eta4ever/ay-serial/pcb/pcb.png

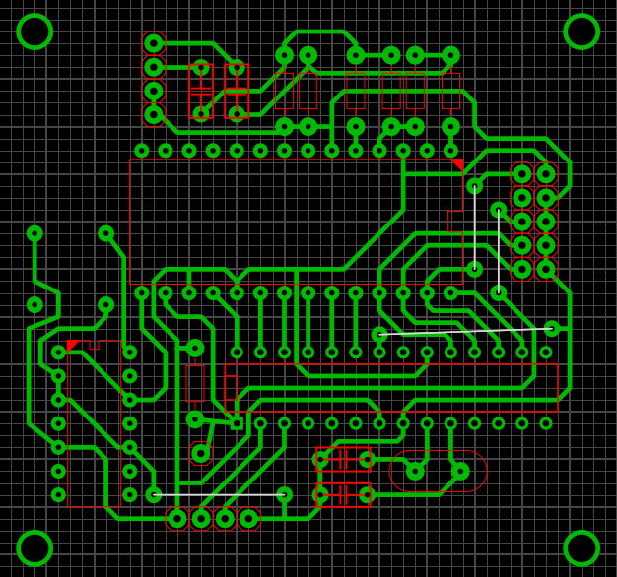
pcb/pcb.png
