eta4ever/ay-serial/sch/sch.png

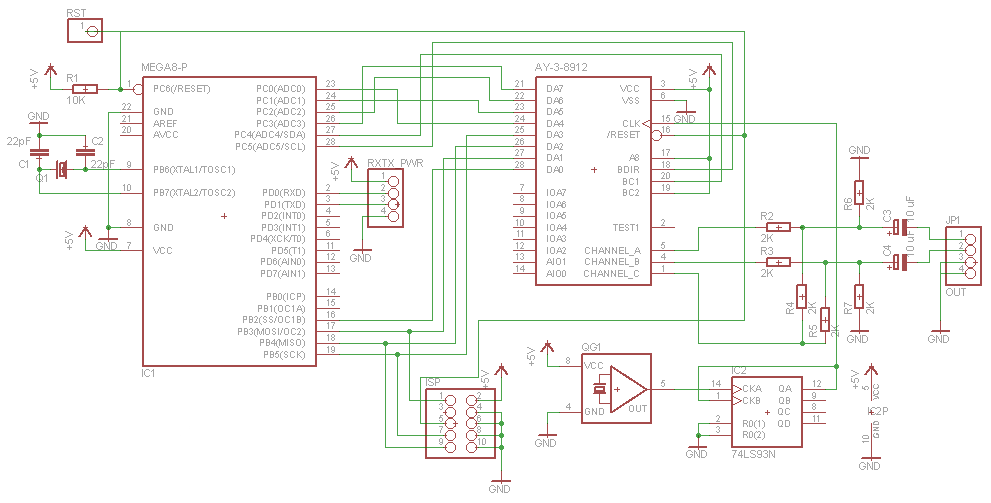
sch/sch.png
