eta4ever/ay-serial/(list of files, drawings)

Other design files:
pcb/chiptune-mega8.lay6
