eta4ever/ay-serial/sch/sch.sch

## EAGLE design sch/sch.sch (2015-03-14)

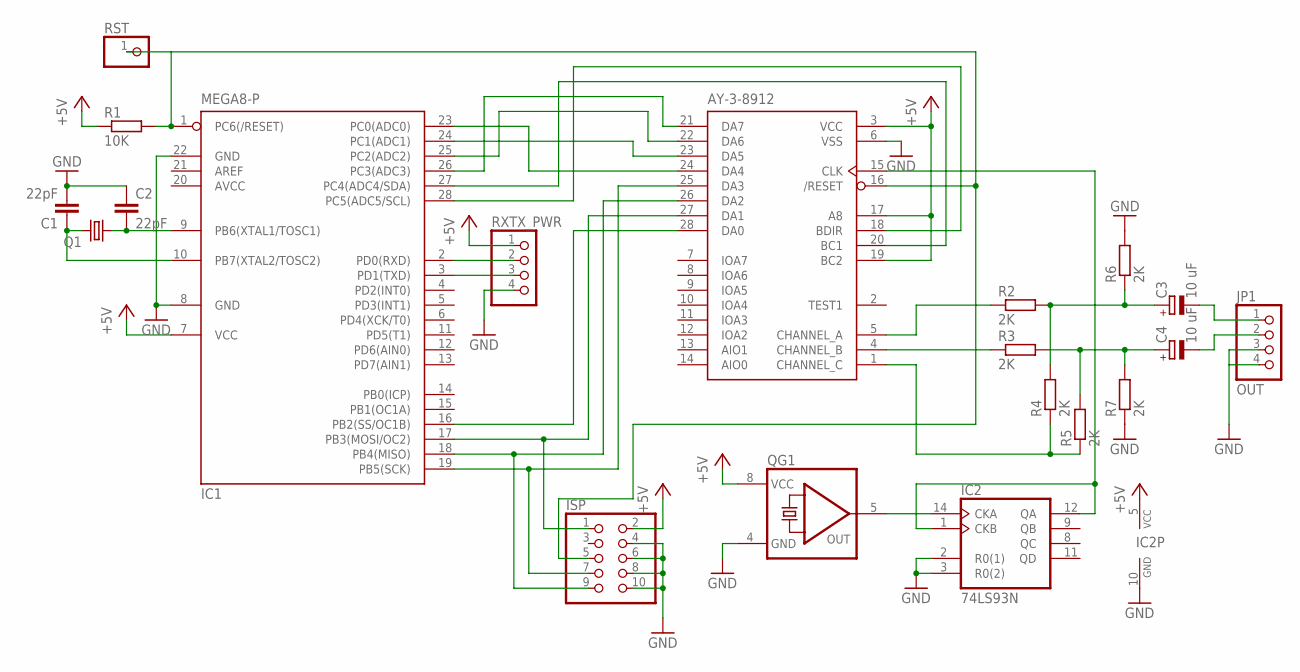
[picture p3: schematic sch.sch]

Parts:
AY-3-8912: AY-3-8912_28PIN; DIL28
C1, C2: 22pF; C2.5-3
C3, C4: 10 uF; E2,5-6E
IC1: MEGA8-P; DIL28-3
IC2: 74LS93N; DIL14
ISP: PINHD-2X5; 2X05
JP1: OUT; 1X04
Q1: CRYSTALHC49U-V; HC49U-V
QG1: QG5460; DIL08S
R1: 10K; 0204/7
R2, R3, R4, R5, R6, R7: 2K; 0204/7
RST: PINHD-1X1; 1X01
RXTX_PWR: PINHD-1X4; 1X04

Connections:
+5V: AY-3-8912.3 (VCC), AY-3-8912.17 (A8), AY-3-8912.19 (BC2), IC1.7 (VCC), IC2.5 (VCC), ISP.2, QG1.8 (VCC), R1.1, RXTX_PWR.1
GND: AY-3-8912.6 (VSS), C1.2, C2.1, IC1.8 (GND), IC1.22 (GND), IC2.2 (R0(1)), IC2.3 (R0(2)), IC2.10 (GND), ISP.4, ISP.6, ISP.8, ISP.10, JP1.3, JP1.4, QG1.4 (GND), R6.2, R7.1, RXTX_PWR.4
unnamed: AY-3-8912.24 (DA4), IC1.23 (PC0(ADC0))
unnamed: AY-3-8912.23 (DA5), IC1.24 (PC1(ADC1))
unnamed: AY-3-8912.22 (DA6), IC1.25 (PC2(ADC2))
unnamed: AY-3-8912.21 (DA7), IC1.26 (PC3(ADC3))
unnamed: AY-3-8912.28 (DA0), IC1.16 (PB2(SS/OC1B))
unnamed: AY-3-8912.27 (DA1), IC1.17 (PB3(MOSI/OC2)), ISP.1
unnamed: AY-3-8912.26 (DA2), IC1.18 (PB4(MISO)), ISP.9
unnamed: AY-3-8912.25 (DA3), IC1.19 (PB5(SCK)), ISP.7
unnamed: AY-3-8912.20 (BC1), IC1.27 (PC4(ADC4/SDA))
unnamed: AY-3-8912.18 (BDIR), IC1.28 (PC5(ADC5/SCL))
unnamed: AY-3-8912.16 (/RESET), IC1.1 (PC6(/RESET)), ISP.5, R1.2, RST.1
unnamed: C2.2, IC1.9 (PB6(XTAL1/TOSC1)), Q1.1
unnamed: C1.1, IC1.10 (PB7(XTAL2/TOSC2)), Q1.2
unnamed: IC2.14 (CKA), QG1.5 (OUT)
unnamed: AY-3-8912.5 (CHANNEL_A), R2.1
unnamed: AY-3-8912.15 (CLK), IC2.1 (CKB), IC2.12 (QA)
unnamed: IC1.2 (PD0(RXD)), RXTX_PWR.2
unnamed: IC1.3 (PD1(TXD)), RXTX_PWR.3
unnamed: AY-3-8912.4 (CHANNEL_B), R3.1
unnamed: C3.+, R2.2, R4.2, R6.1
unnamed: C4.+, R3.2, R5.2, R7.2
unnamed: AY-3-8912.1 (CHANNEL_C), R4.1, R5.1
unnamed: C3.-, JP1.1
unnamed: C4.-, JP1.2
