eta4ever/ay-serial/(commit log)

2015-03-13 немного readme
2015-03-14 запись тишины в конце воспроизведения
2015-03-14 Добавлена схема
    [sch.sch]
2015-03-14 RST pin
    [chiptune-mega8.lay6]
2015-03-14 pcb & sch png
2015-03-18 пробуем приемный буфер
2015-03-18 Тактирование 50 Гц на Atmega, буферизация приема с обратной связью
2015-03-19 raspberry host
